baltic-racing/BSPD-Brake-System-Plausibility-Device/BSPD_TY22/01 - Parts/BSPD_Main/SCH_BSPD_Main_V2.pdf

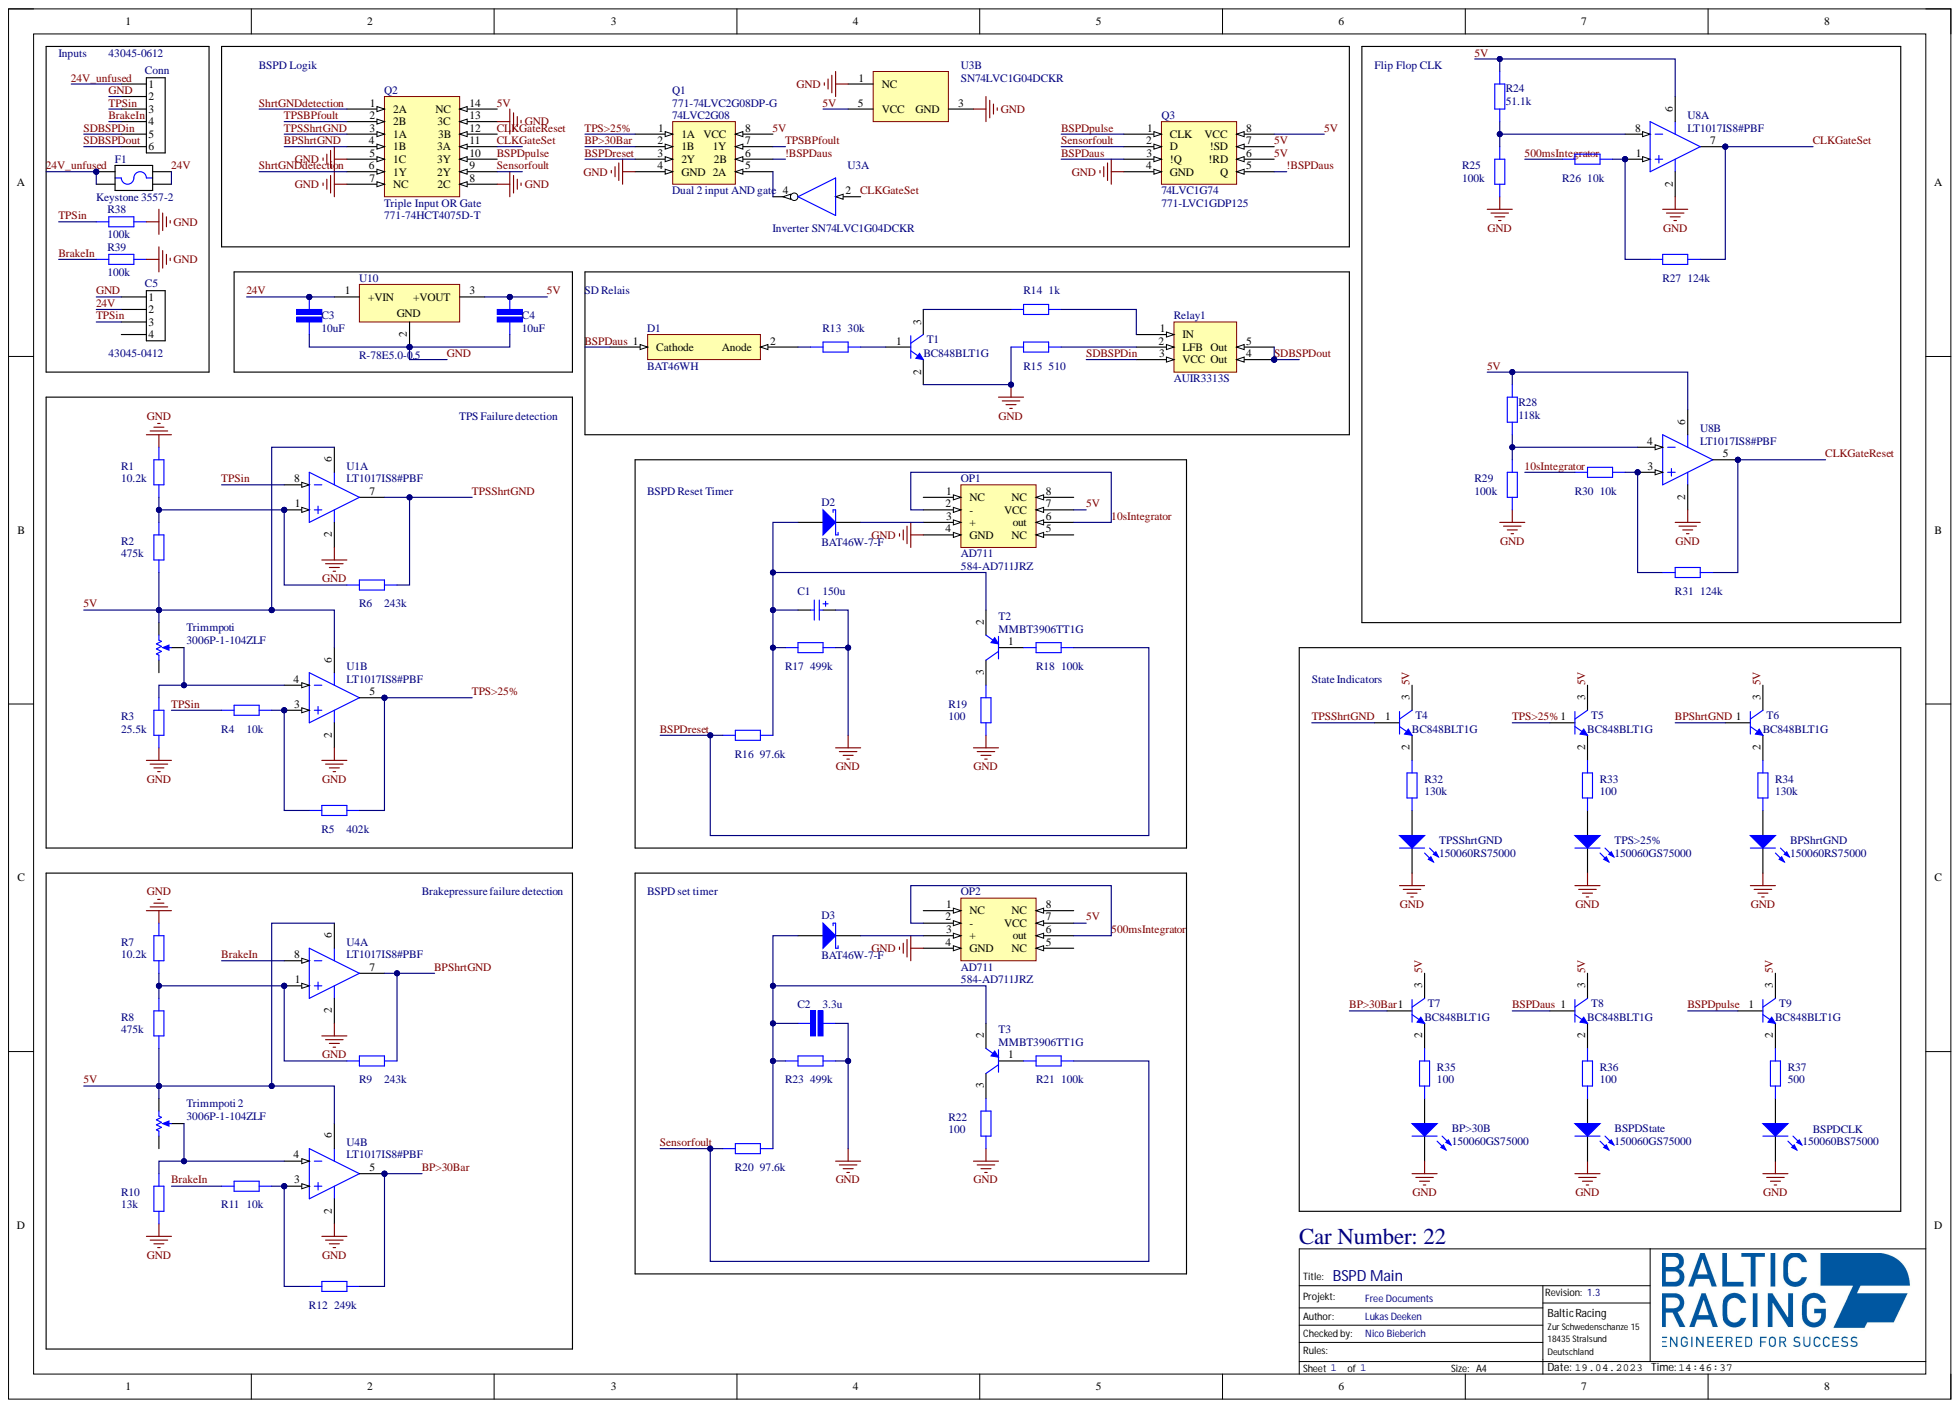
[picture p1: page 1]

Dual 2 input AND gate
