baltic-racing/BSPD-Brake-System-Plausibility-Device/BSPD_TY22/01 - Parts/BSPD_Sensorboard/SCH_BSPD_Sensorboard.pdf

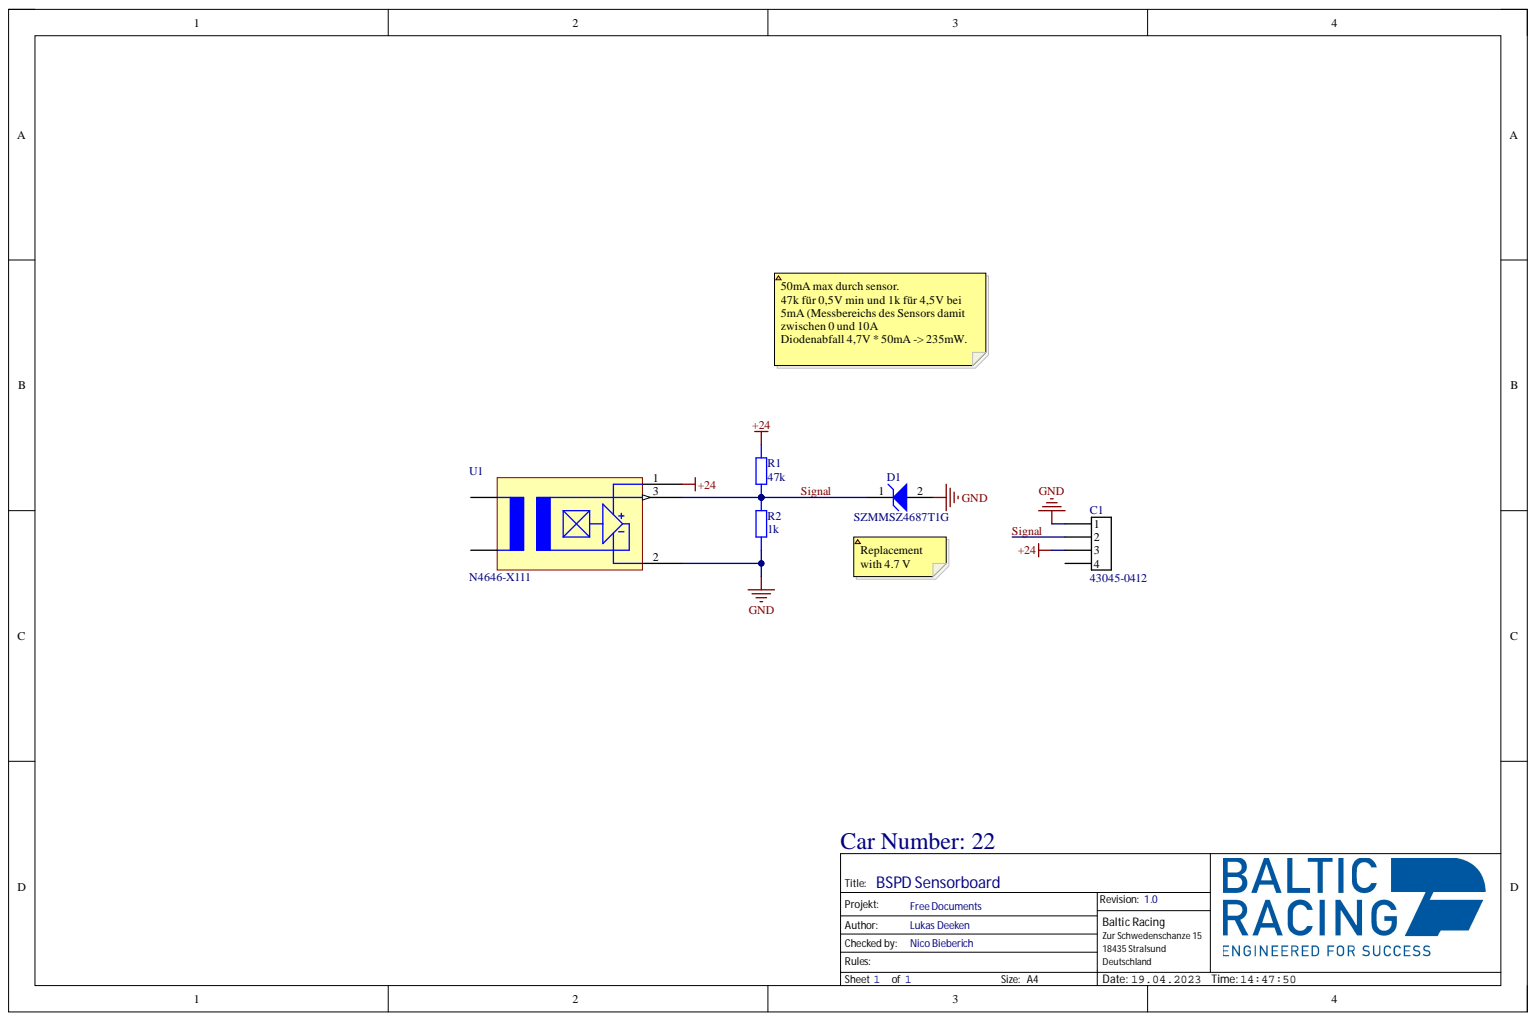
[picture p2: page 1]
