baltic-racing/BSPD-Brake-System-Plausibility-Device/BSPD_TY22/01 - Parts/BSPD_Main/SCH_BSPD_Main.pdf

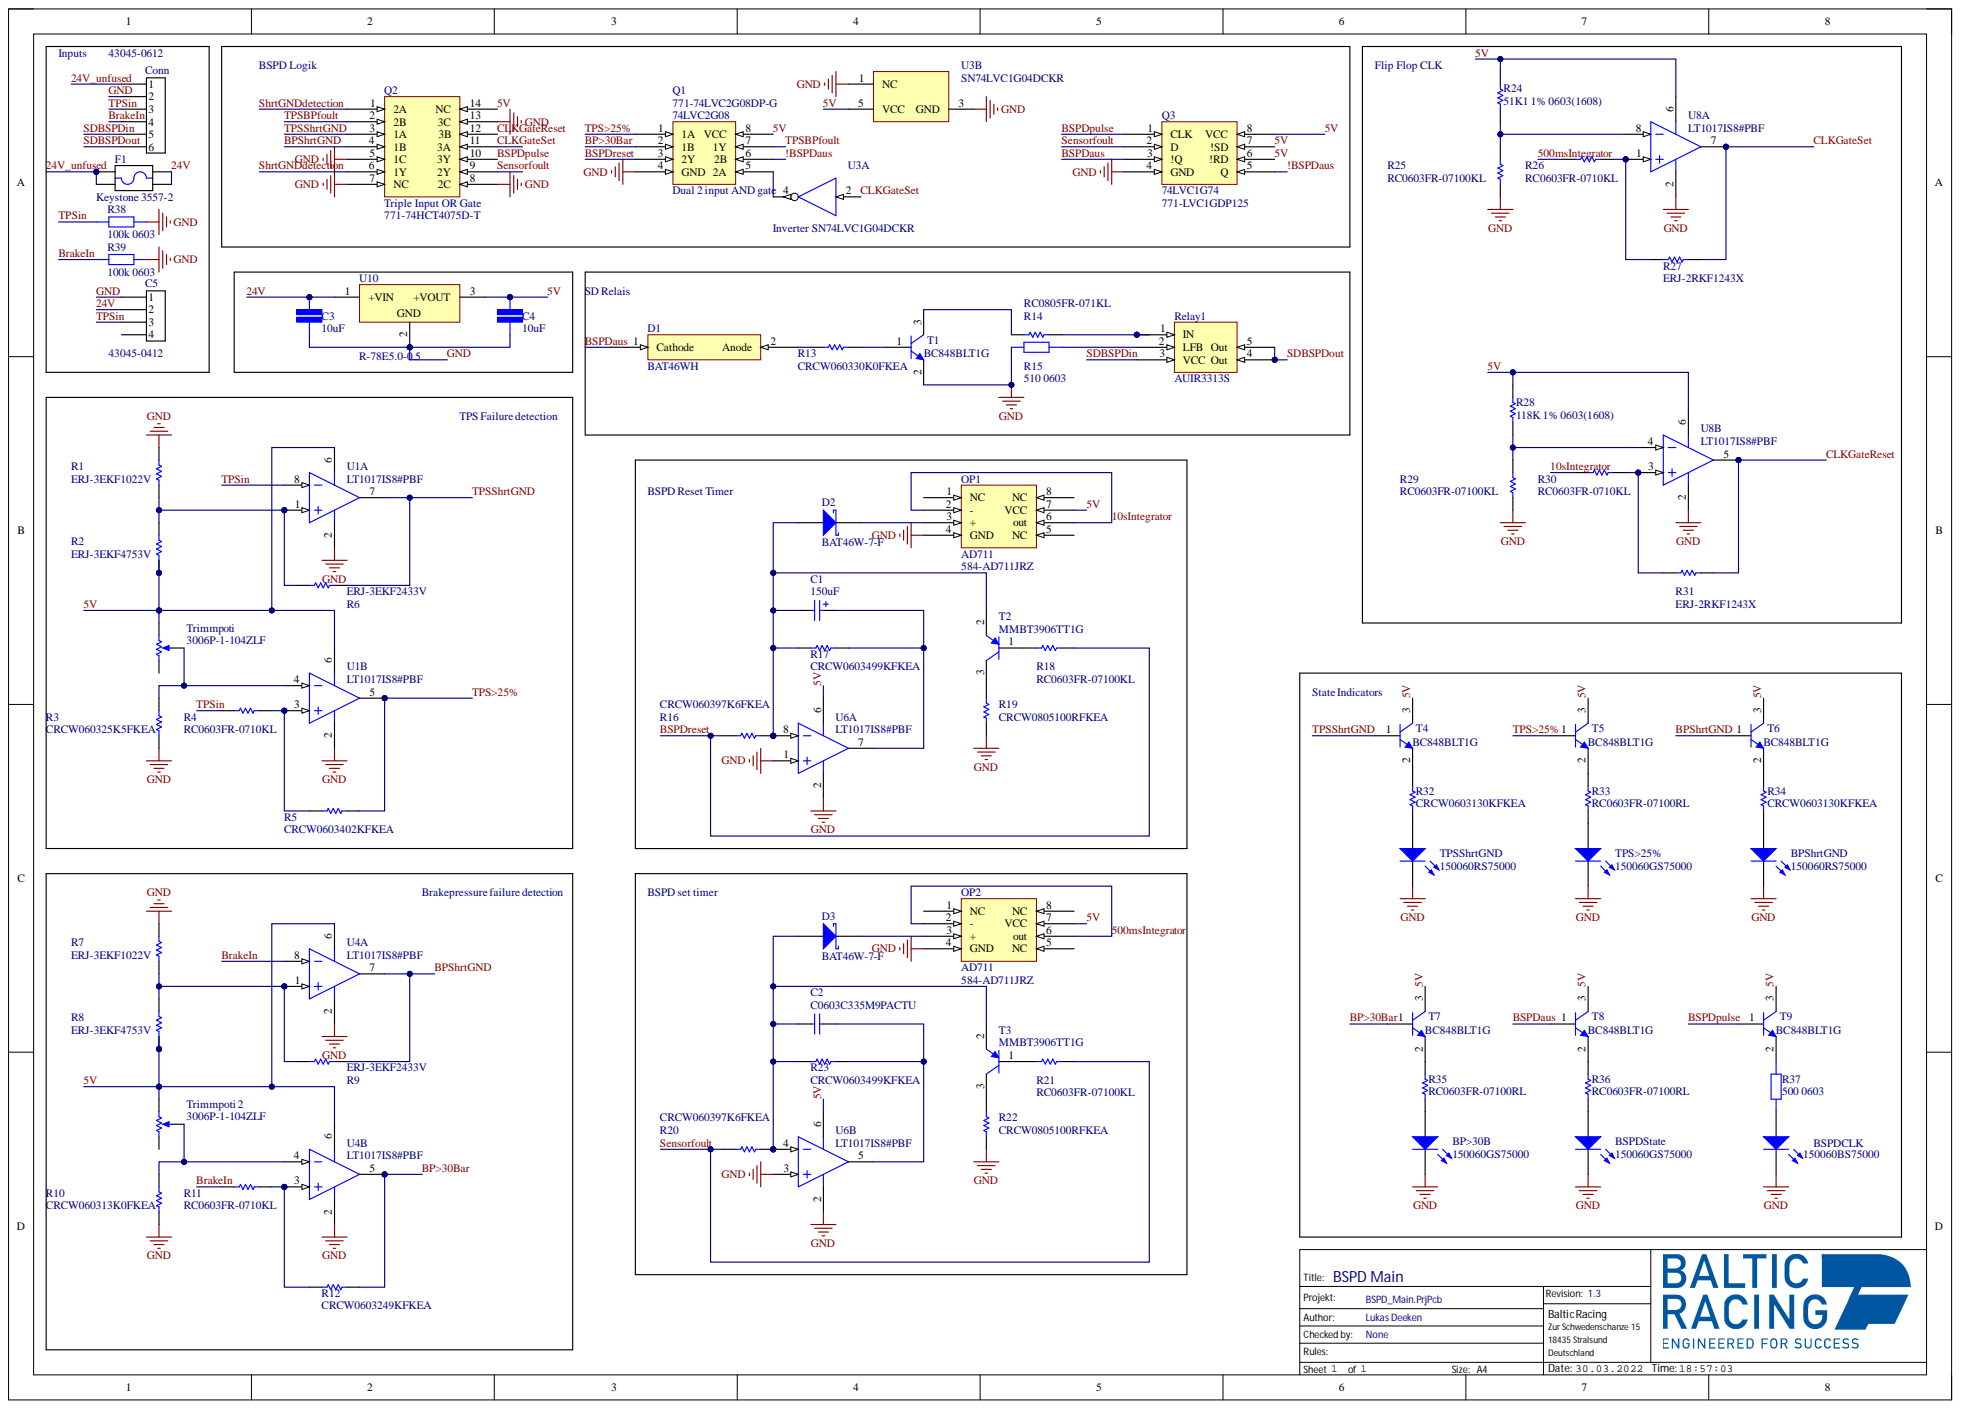
[picture p3: page 1]

Dual 2 input AND gate
