baltic-racing/BSPD-Brake-System-Plausibility-Device/Simulation/Sensorboard_Sim.asc

D1: zener; 1N750
I1: current; PULSE(0 5m 0 3 0.5 0.5 0 1)
R1: res; 1k
R2: res; 10.2K; tol=1 pwr=0.1
R3: res; 47k
R4: res; 475K; tol=1 pwr=0.1
R5: res; 6k; tol=1 pwr=0.1
R6: res; 25.5K; tol=1 pwr=0.1
R7: res; 243K; tol=1 pwr=0.1
R8: res; 10K; tol=1 pwr=0.1
R9: res; 402K; tol=1 pwr=0.1
U1: LT1017
U2: LT1017
V1: voltage; 24V
V2: voltage; 5
Named nets: 0, Signal
.tran 4
TPS fault detection
bis 100k Trimmpoti
Power-Current Sensing Value
Power-Current Sensing short to GND
