baltic-racing/BSPD-Brake-System-Plausibility-Device/Simulation/BSPD_SIM_V2.asc

A1: or; Vhigh=5 Vlow=0
A4: dflop; Vhigh=5 Vlow=0
A5: inv; Vhigh=5 Vlow=0
A6: and; Vhigh=5 Vlow=0
A8: and; Vhigh=5 Vlow=0
A9: or; Vhigh=5 Vlow=0
A10: or; Vhigh=5 Vlow=0
C1: cap; 3.3µ; V=16 Irms=4.84 Rser=0.00925238 Lser=0 mfg="KEMET" pn="C1206C335K4RAC" type="X7R"
C2: polcap; 150µ; V=16 Irms=1.75713 Rser=0.08 Lser=0 mfg="KEMET" pn="T521X157M016ATE080" type="Tantalum"
D1: schottky; BAT46WJ
D2: schottky; BAT46WJ
Q1: pnp; 2N2907
Q2: pnp; 2N2907
R1: res; 10.2K; tol=1 pwr=0.1
R2: res; 475K; tol=1 pwr=0.1
R3: res; 43.2K; tol=1 pwr=0.1
R4: res; 13k; tol=1 pwr=0.1
R5: res; 243K; tol=1 pwr=0.1
R6: res; 10K; tol=1 pwr=0.1
R7: res; 249K; tol=1 pwr=0.1
R8: res; 10.2K; tol=1 pwr=0.1
R9: res; 475K; tol=1 pwr=0.1
R10: res; 16.2K; tol=1 pwr=0.1
R11: res; 25.5K; tol=1 pwr=0.1
R12: res; 243K; tol=1 pwr=0.1
R13: res; 10K; tol=1 pwr=0.1
R14: res; 402K; tol=1 pwr=0.1
R15: res; 97.6K; tol=1 pwr=0.1
R16: res; 499K; tol=1 pwr=0.1
R17: res; 100K; tol=1 pwr=0.1
R18: res; 10K; tol=1 pwr=0.1
R19: res; 124K; tol=1 pwr=0.1
R20: res; 51.1K; tol=1 pwr=0.1
R21: res; 100K; tol=1 pwr=0.1
R22: res; 499K; tol=1 pwr=0.1
R23: res; 100K; tol=1 pwr=0.1
R24: res; 100K; tol=1 pwr=0.1
R25: res; 100K; tol=1 pwr=0.1
R26: res; 10K; tol=1 pwr=0.1
R27: res; 124K; tol=1 pwr=0.1
R28: res; 118K; tol=1 pwr=0.1
R29: res; 100; tol=1 pwr=0.1
R30: res; 100
U1: LT1017
U2: LT1017
U3: LT1017
U4: LT1017
U6: LT1017
U7: AD711
U8: LT1017
U10: AD711
V1: voltage; 5
V2: voltage; PULSE(0 5.5 2 25 35 2 65)
V3: voltage; PULSE(0 5.5 2 25 35 2 65)
V4: voltage; 5
V5: voltage; 5
V6: voltage; 5
V8: voltage; 5
V9: voltage; 5
Named nets: 0, falsesetaus, BSPDaus, TPSSrtGND, TPS>25%, BPSrtGND, BP>30Bar, !BSPDaus
.tran 200
500ms integrator
500ms integrator trigger
10s integrator
10s integrator switch
TPS fault detection
Brake flault detection
Set to 3.125 and 3V
Set to 0.3 and 0.1V
Set To 1.2 and 1V
Set to 0.3 and 0.1V
bis 100k Trimmpoti
bis 100k Trimmpoti
