baltic-racing/BSPD-Brake-System-Plausibility-Device/(list of files, drawings)

Other design files:
BSPD_Lukas/BSPDLukas/BSPDLukas.PrjPcb
BSPD_TY22/01 - Parts/BSPD_Main/BSPD_Main.PrjPcb
BSPD_TY22/01 - Parts/BSPD_Main/PCB_BSPD_Main.PcbDoc
BSPD_TY22/01 - Parts/BSPD_Main/SCH_BSPD_Main.SchDoc
BSPD_TY22/01 - Parts/BSPD_Sensorboard/BSPD_Sensorboard.PrjPcb
BSPD_TY22/01 - Parts/BSPD_Sensorboard/PCB_BSPD_Sensorboard.PcbDoc
BSPD_TY22/01 - Parts/BSPD_Sensorboard/SCH_BSPD_Sensorboard.SchDoc
