baltic-racing/BSPD-Brake-System-Plausibility-Device/(commit log)

2020-02-19 Uploading the BSPD FIles
    [BSPDLukas.PrjPcb, PCB1.PcbDoc, Sheet1.SchDoc]
2020-02-19 finalised Board layout for check.
    [PCB1.PcbDoc, Sheet1.SchDoc]
2020-02-29 Rerouted a bit to get more vias of the pads changed to m2 screws an edited board outline
    [PCB1.PcbDoc]
2020-07-31 Rerouted the Bullshit of layout i created before
    [BSPDLukas.PrjPcb, PCB1.PcbDoc, Sheet1.SchDoc]
2020-09-27 added Pulldown for sensor and updated footprint for auir 3313
    [BSPDLukas.PrjPcb, PCB_BSPDV1_1.PcbDoc, PCB_BSPDV1_2.PcbDoc, Sheet1.SchDoc]
2020-10-08 layouted new BSPD PCB
    [BSPDLukas.PrjPcb, PCB_BSPDV1_2.PcbDoc]
2020-10-20 Few Minor Changes plus Stackup Indicator
    [PCB_BSPDV1_2.PcbDoc, Sheet1.SchDoc]
2022-01-06 Started new BSPD Multiboard Project for TY22
    [PCB1.PcbDoc, PCB_BSPDV1_1.PcbDoc, PCB_BSPDV1_2.PcbDoc, Sheet1.SchDoc]
2022-01-06 renamed BSPD Sim and added Sim FIle for the Sensorboard
2022-01-06 added BSPD_Main Subproject
    [BSPD_Main.PrjPcb, PCB_BSPD_Main.PcbDoc, SCH_BSPD_Main.SchDoc]
2022-01-06 added Sensorboard Subpreoject and changed folder structure
    [BSPD_Main.PrjPcb, BSPD_Sensorboard.PrjPcb, PCB_BSPD_Main.PcbDoc, PCB_BSPD_Sensorboard.PcbDoc, SCH_BSPD_Main.SchDoc, SCH_BSPD_Sensorboard.SchDoc]
2022-02-08 mod for TY22
    Added Diodes for the Voltage Follower, fixed error on the transistor reset of the capacitors and added the second connector for the extnesion board
    [BSPD_Main.PrjPcb, PCB_BSPD_Main.PcbDoc, SCH_BSPD_Main.SchDoc]
2022-02-08 mod. sensor board sim
    added 0.5V bottom limit
2022-02-10 worked sensorboard schematic in
    [SCH_BSPD_Sensorboard.SchDoc]
2022-02-11 mod. Sensorboard sim
2022-02-11 finished sensorboard
    [PCB_BSPD_Sensorboard.PcbDoc, SCH_BSPD_Sensorboard.SchDoc]
2022-02-11 finished BSPD for TY22
    [PCB_BSPD_Main.PcbDoc, SCH_BSPD_Main.SchDoc]
2022-05-13 changed template only cosmetic changes
    [BSPD_Main.PrjPcb, BSPD_Sensorboard.PrjPcb, PCB_BSPD_Main.PcbDoc, SCH_BSPD_Main.SchDoc, SCH_BSPD_Main_2.SchDoc, SCH_BSPD_Sensorboard.SchDoc]
2022-05-14 added gerber files for manufacturing
    [BSPD_Main.PrjPcb, PCB_BSPD_Main.PcbDoc]
2022-05-14 add gerber files for sensorboard
2022-05-14 saved project
    [BSPD_Sensorboard.PrjPcb]
2022-06-12 added a few imges and stuff
    [BSPD_Main.PrjPcb, PCB_BSPD_Main.PcbDoc]
2022-06-12 generated gerbers
    [BSPD_Main.PrjPcb, PCB_BSPD_Main.PcbDoc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]
2022-06-13 added board outline to sensorboard
    [BSPD_Main.PrjPcb, BSPD_Sensorboard.PrjPcb, PCB_BSPD_Sensorboard.PcbDoc]
2022-11-26 removed OPAMP for Integrator as simplyfication
    [BSPD_Main.PrjPcb, SCH_BSPD_Main.SchDoc]
2023-03-08 Simulation Edit on Sensorboard
    Wrong Sensor was bought.
    N4646-X100 -> N4646-X111
    Added Power Current Sensing Trigger for better visualization.
2023-03-16 Minor change on Sensorboard Schematic
    Due to wrong orderd Sensor, the resistors were adapted to new one
    [SCH_BSPD_Sensorboard.SchDoc]
2023-04-19 Small Edit on Simulation of Sensorboard
2023-04-19 Edit on main schematic.
    Replaced Symbols of various Resistors for ESF.
    [BSPD_Main.PrjPcb, SCH_BSPD_Main.SchDoc, SCH_BSPD_Main_2.SchDoc]
2023-04-19 New Sensorboard .pdf Export
2023-04-19 Minor edit on schematic for ESF
    [SCH_BSPD_Main.SchDoc, SCH_BSPD_Sensorboard.SchDoc]
